biancabuga/Proiect-Final-PCB/Images/PCB.png

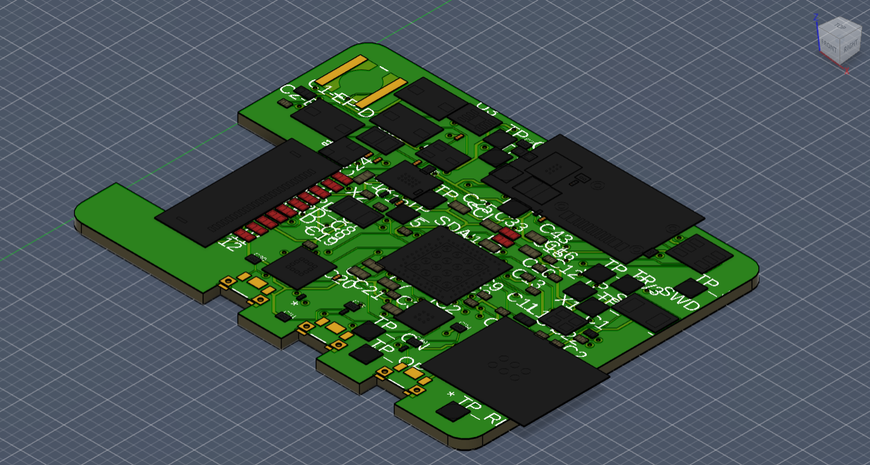
Images/PCB.png
