biancabuga/Proiect-Final-PCB/Images/placa in carcasa.png

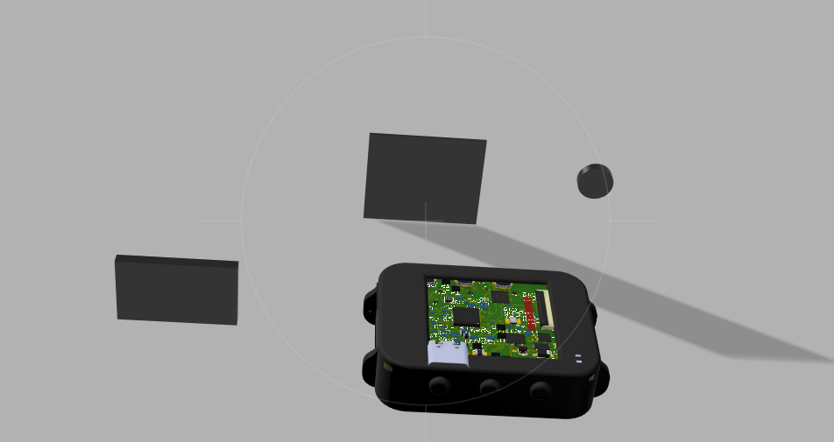
Images/placa in carcasa.png
