biancabuga/Proiect-Final-PCB/Images/watch.png

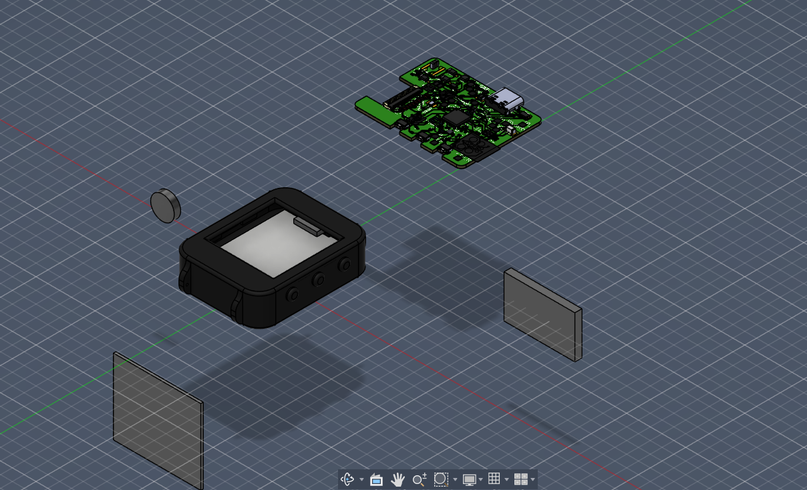
Images/watch.png
