biancabuga/Proiect-Final-PCB/Images/watchme.png

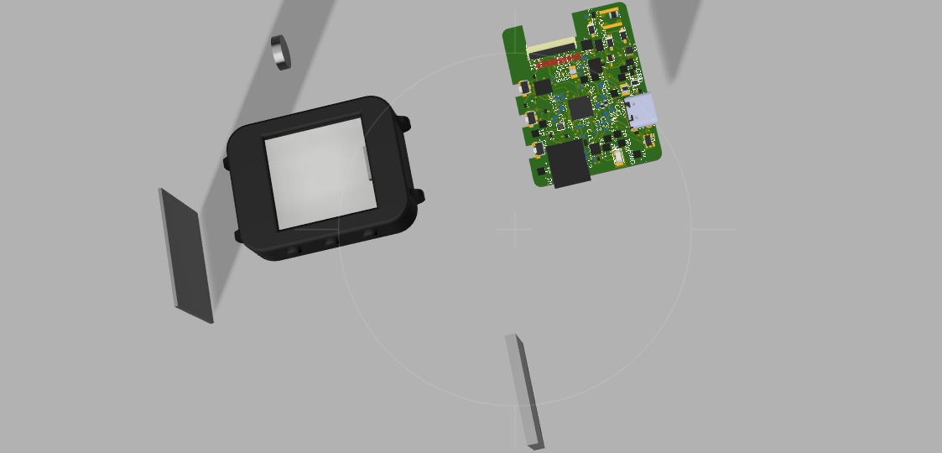
Images/watchme.png
