biancabuga/Proiect-Final-PCB/Mechanical/Screenshot 2026-04-21 143959.png

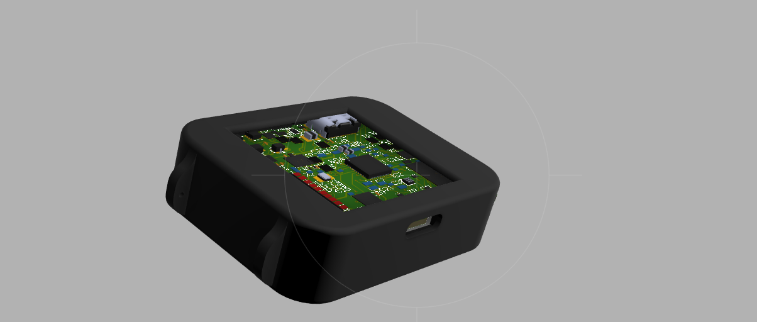
Mechanical/Screenshot 2026-04-21 143959.png
