biancabuga/Proiect-Final-PCB/Images/PCB WITH COMPONENTS.png

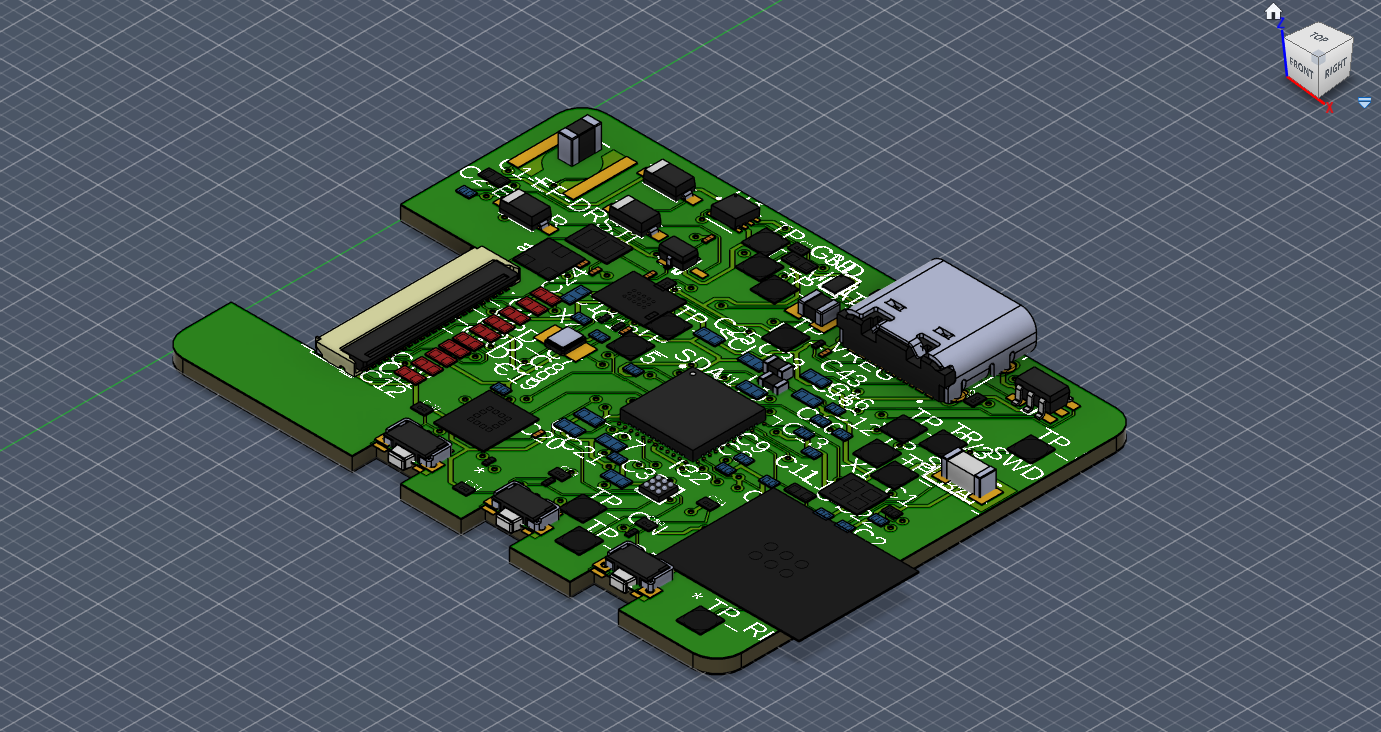
Images/PCB WITH COMPONENTS.png
