biancabuga/Proiect-Final-PCB/Hardware/Schematic.pdf

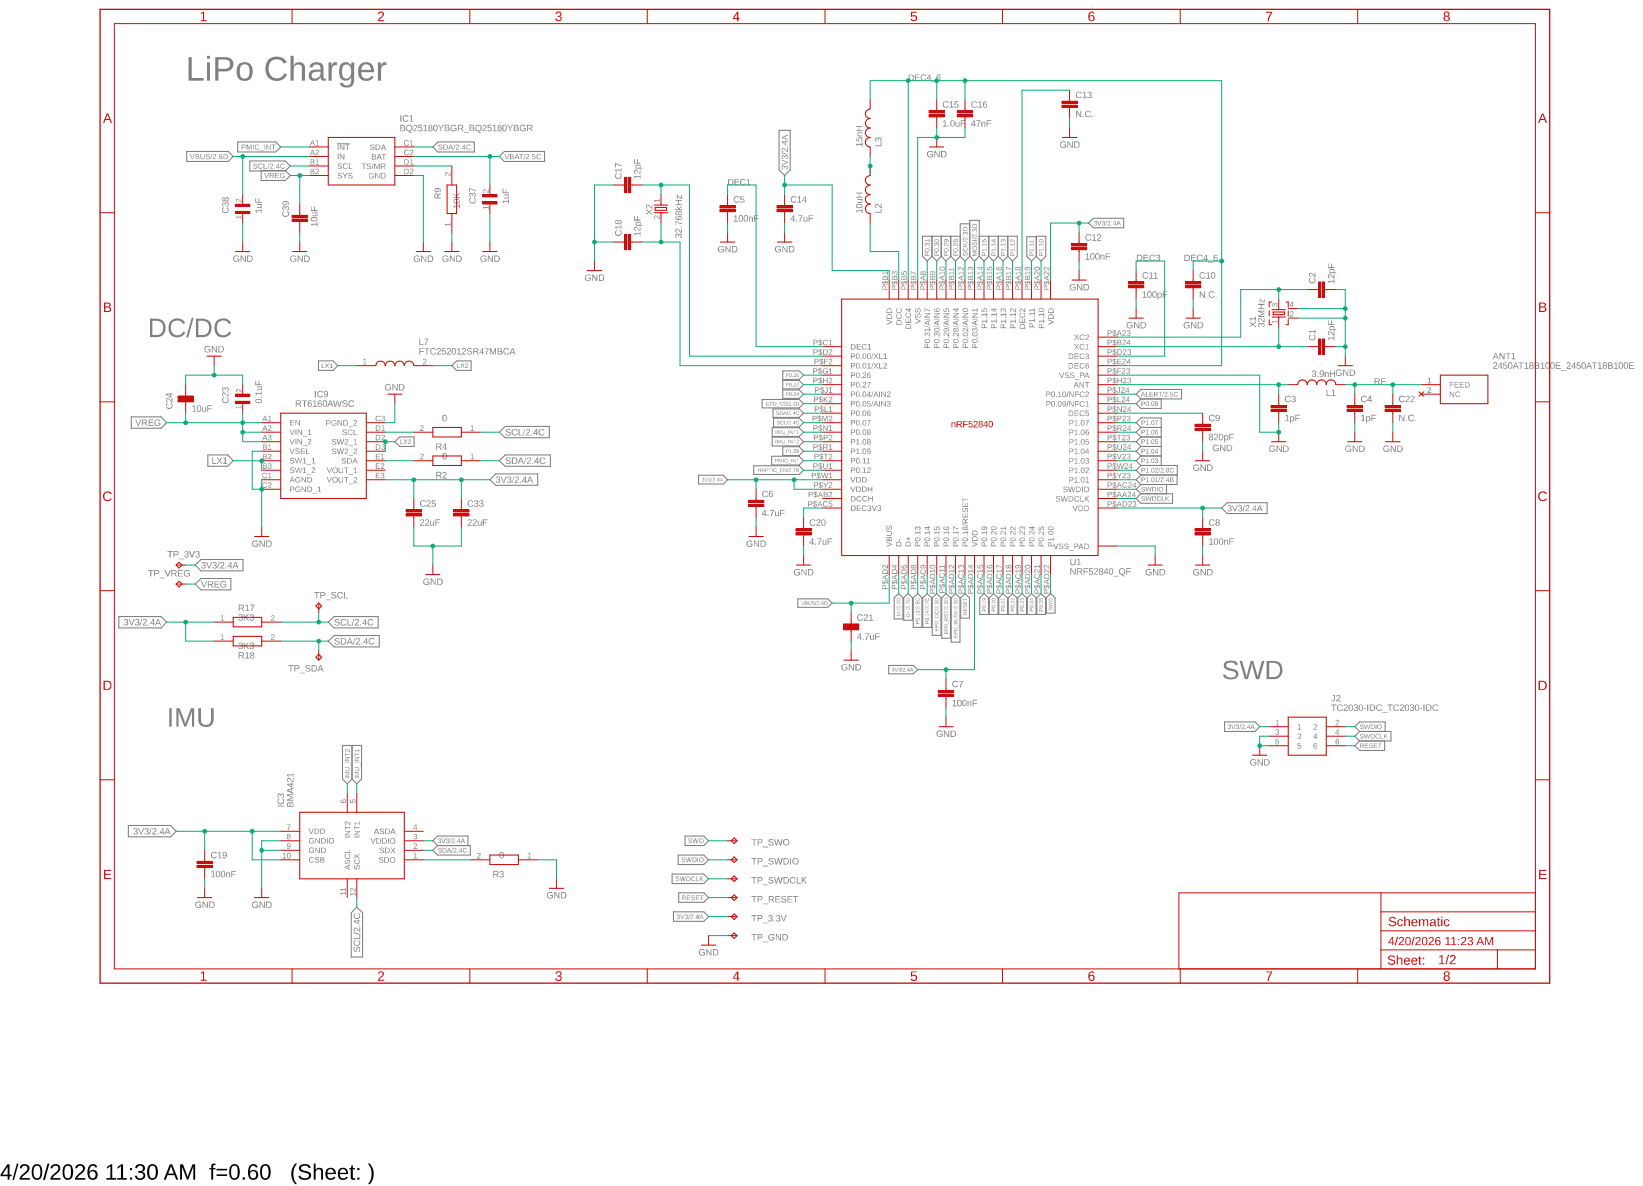
[picture p7: page 1]

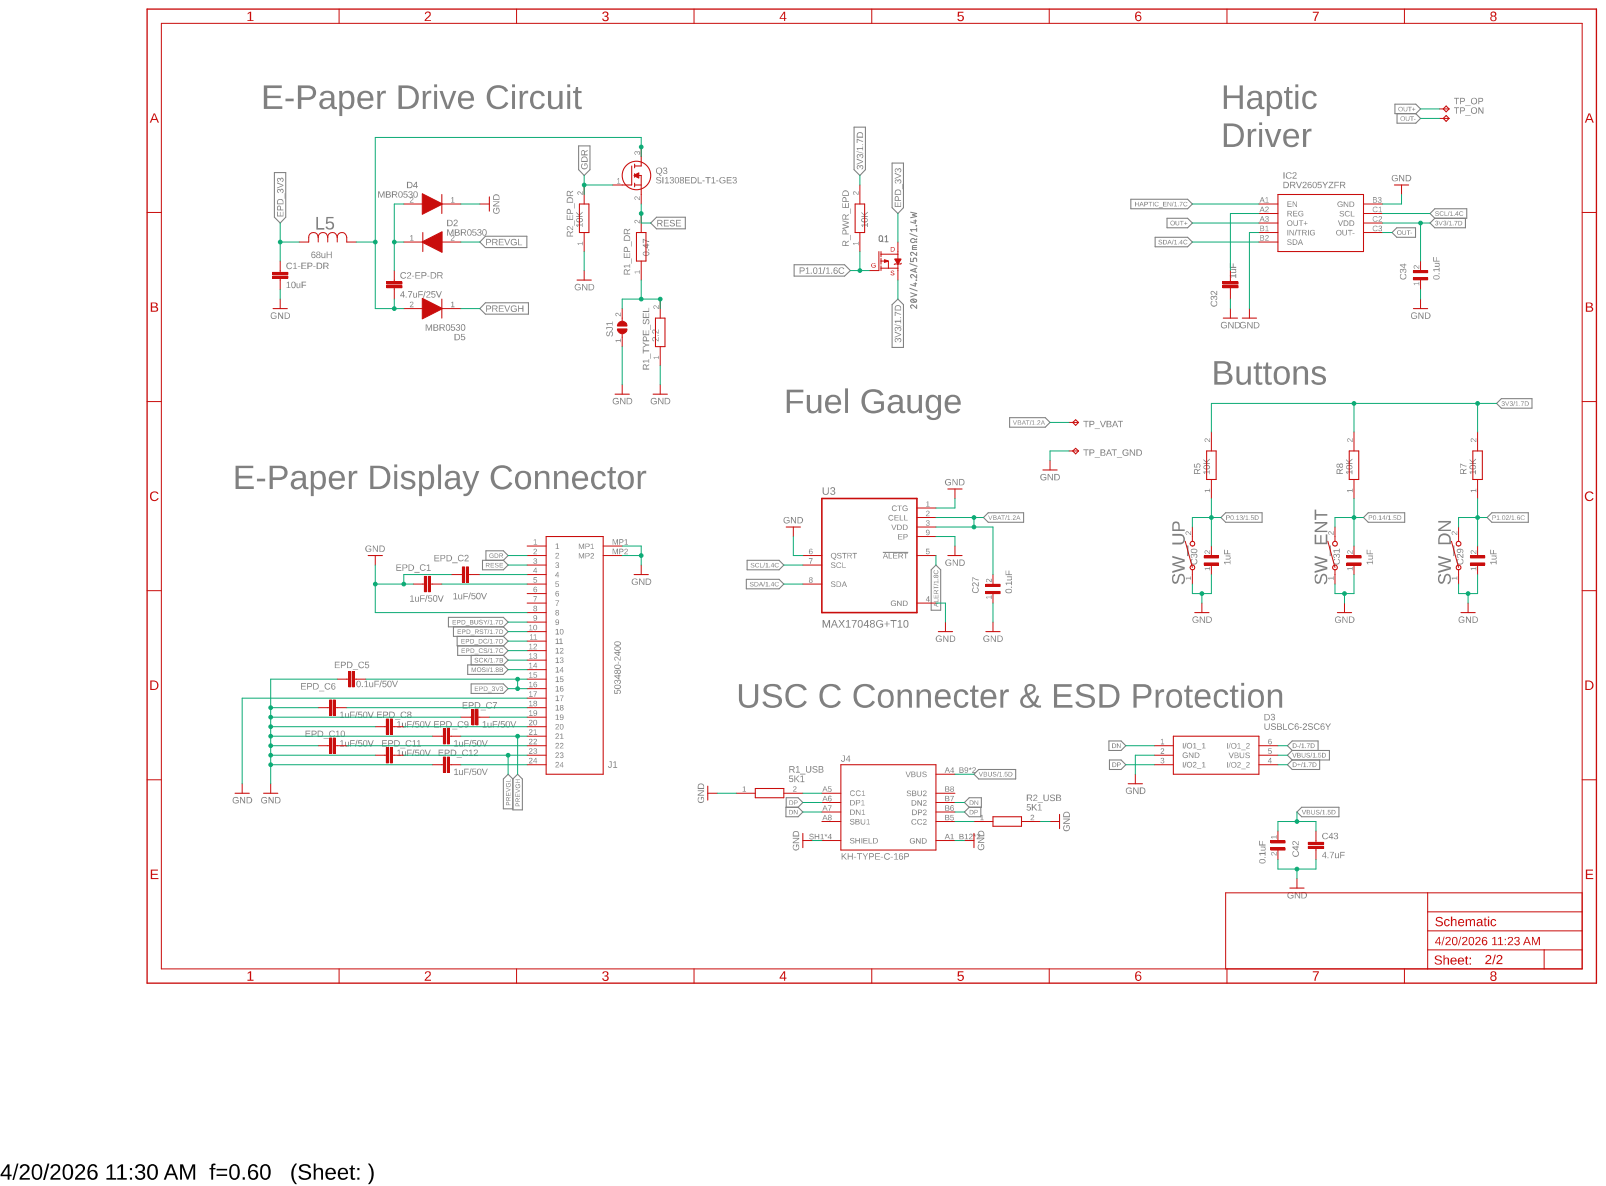
[picture p8: page 2]
