biancabuga/Proiect-Final-PCB/(commit log)

2026-04-14 second commit
    [PCB.brd]
2026-04-14 third commit
    [PCB.csv]
2026-04-15 fourth commit
    [PnP_PCB_front.csv]
2026-04-17 battery + buzzer
2026-04-18 modified pcb
2026-04-20 print out schematic
    [PCB.brd]
2026-04-21 new pcb
    [PCB.brd]
