biancabuga/Proiect-Final-PCB/(notices)

Notices in the files:
parts and their libraries:
COPYRIGHT: Copyright (C) 2024 Ultra Librarian. All rights reserved.
COPYRIGHT: Copyright (C) 2025 Ultra Librarian. All rights reserved.
